polpo/picogus/hw-hand386/PicoGUS Hand386.kicad_pcb

## KiCad design hw-hand386/PicoGUS Hand386.kicad_pcb (2024-06-30)

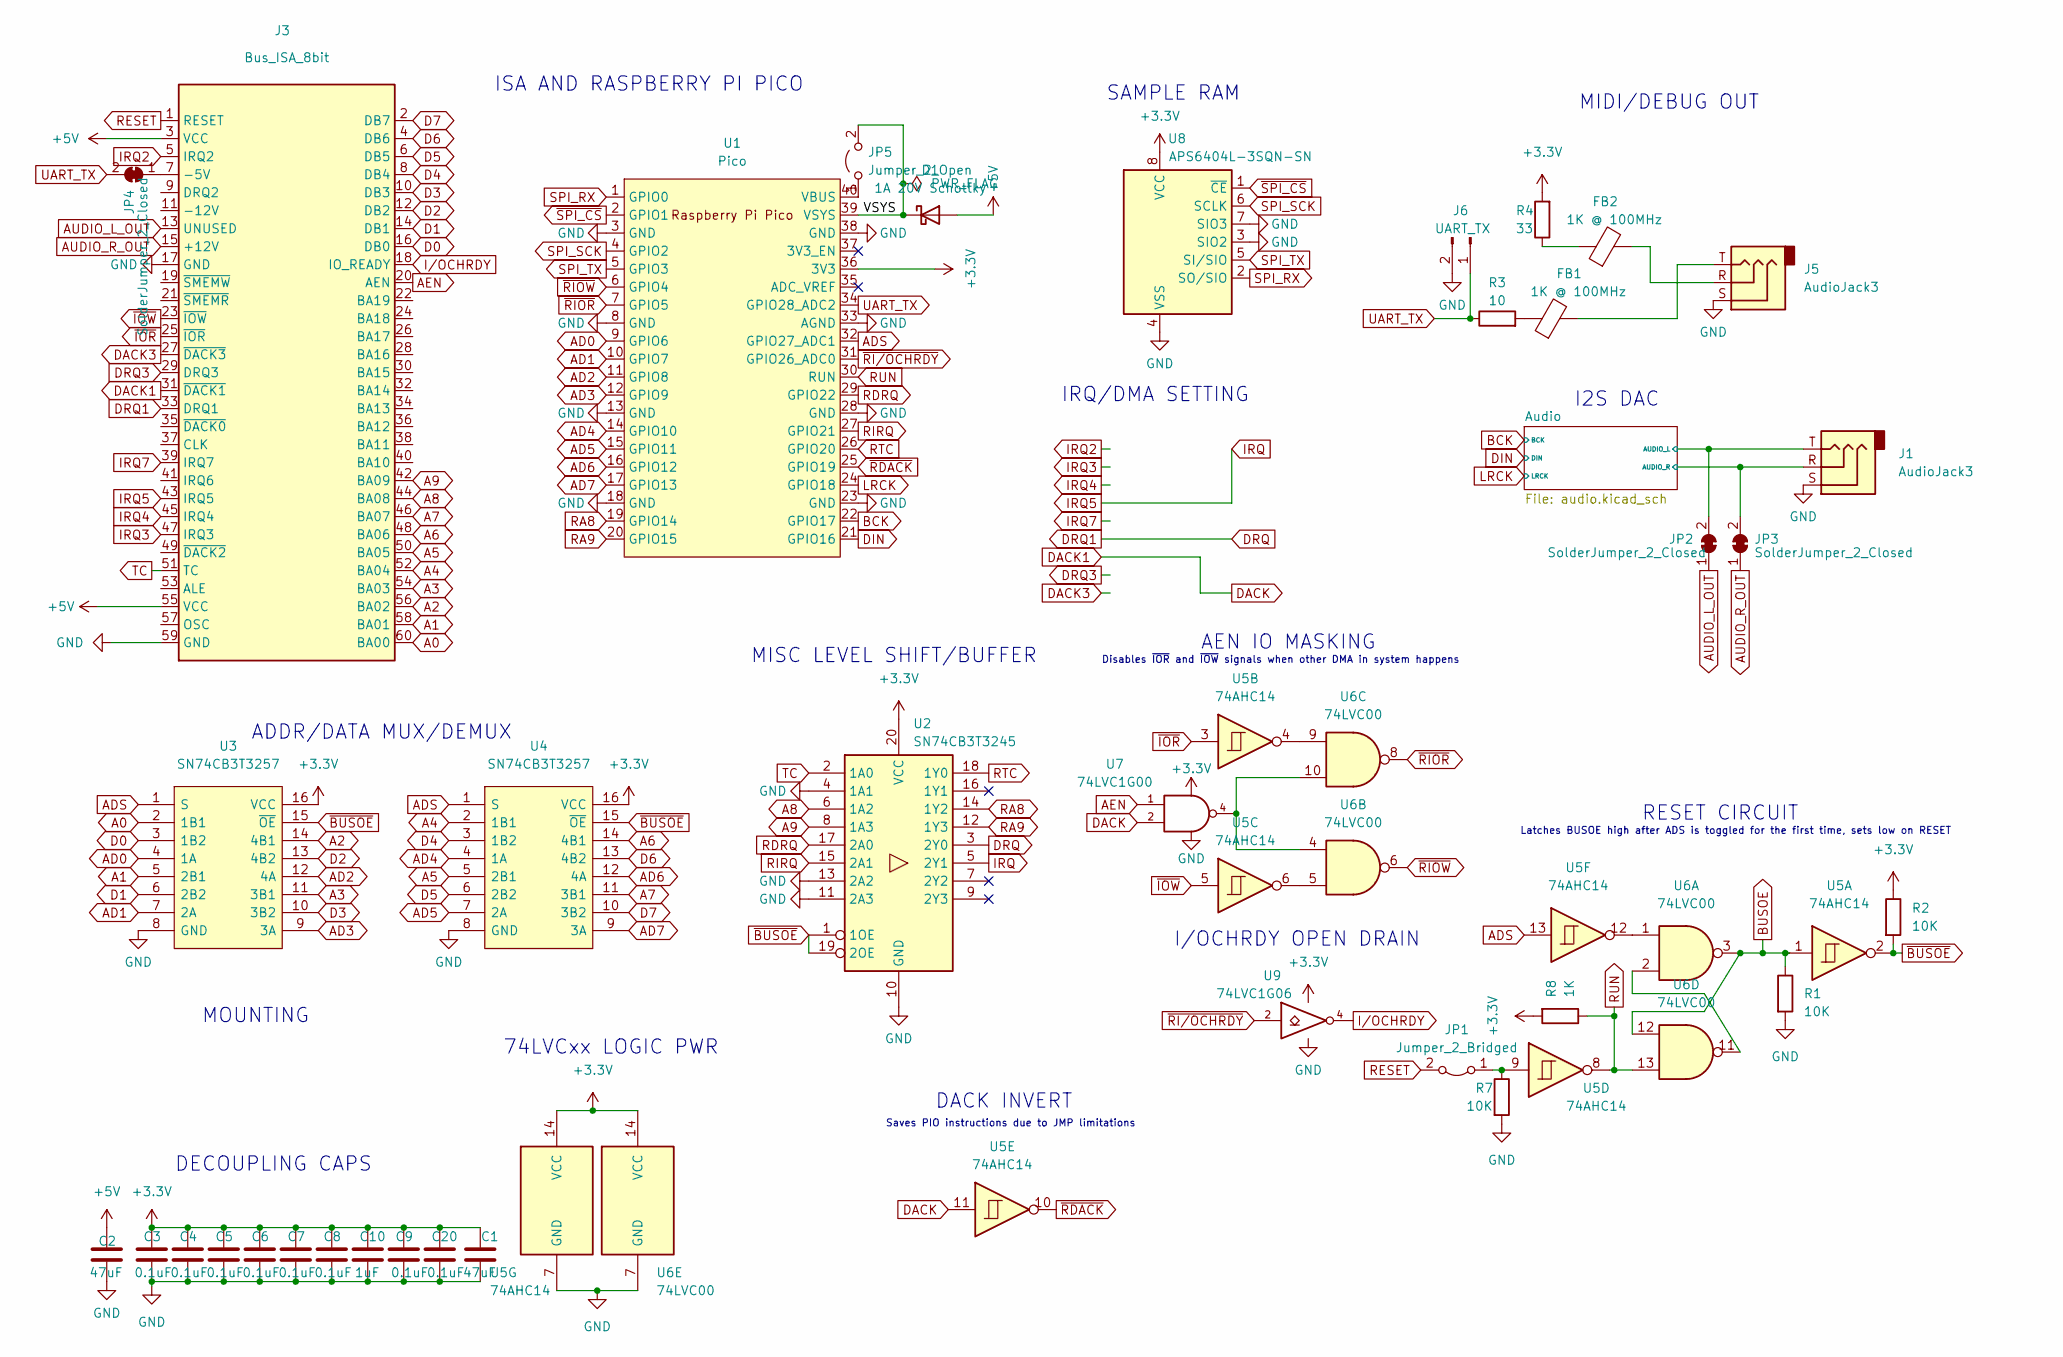
[picture p1: schematic PicoGUS Hand386.kicad_sch, PicoGUS v1.1]

Parts:
C1, C2: 47uF; C_1206_3216Metric
C3, C4, C5, C6, C7, C8, C9, C20: 0.1uF; C_0402_1005Metric
C10: 1uF; C_0402_1005Metric
D1: 1A 20V Schottky; D_SOD-123
FB1, FB2: 1K @ 100MHz; L_0603_1608Metric
J1: AudioJack3; PJ-321A
J3: Bus_ISA_8bit; EDGE-60
J5: AudioJack3; PJ-231F-4A
J6: UART_TX; PinHeader_1x02_P2.54mm_Vertical
JP1: Jumper_2_Bridged; PinHeader_1x02_P2.54mm_Vertical
JP2, JP3, JP4: SolderJumper_2_Closed; SolderJumper-2_P1.3mm_Bridged_RoundedPad1.0x1.5mm-nomask
JP5: Jumper_2_Open; PinHeader_1x02_P2.54mm_Vertical
R1, R2, R7: 10K; R_0402_1005Metric
R3: 10; R_0805_2012Metric
R4: 33; R_0805_2012Metric
R8: 1K; R_0402_1005Metric
U1: Pico; RPi_Pico_SMD_TH
U2: SN74CB3T3245; TSSOP-20_4.4x6.5mm_P0.65mm
U3, U4: SN74CB3T3257; TSSOP-16_4.4x5mm_P0.65mm; Manufacturer_Part_Number 74FST3257DR2G; Mouser Part Number 863-74FST3257DR2G
U5: 74AHC14; TSSOP-14_4.4x5mm_P0.65mm
U6: 74LVC00; TSSOP-14_4.4x5mm_P0.65mm
U7: 74LVC1G00; SOT-23-5
U8: APS6404L-3SQN-SN; SOIC-8_3.9x4.9mm_P1.27mm
U9: 74LVC1G06; SOT-23-5

Connections:
+5V: C2.1, D1.2 (A), J3.3 (VCC), J3.55 (VCC)
/Audio/AUDIO_L: J1.T, JP2.2 (B); also elsewhere on the board
/Audio/AUDIO_R: J1.R, JP3.2 (B); also elsewhere on the board
/VSYS: D1.1 (K), JP5.2 (B), U1.39 (VSYS)
A0: J3.60 (BA00), U3.2 (1B1)
A1: J3.58 (BA01), U3.5 (2B1)
A2: J3.56 (BA02), U3.14 (4B1)
A3: J3.54 (BA03), U3.11 (3B1)
A4: J3.52 (BA04), U4.2 (1B1)
A5: J3.50 (BA05), U4.5 (2B1)
A6: J3.48 (BA06), U4.14 (4B1)
A7: J3.46 (BA07), U4.11 (3B1)
A8: J3.44 (BA08), U2.6 (1A2)
A9: J3.42 (BA09), U2.8 (1A3)
AD0: U1.9 (GPIO6), U3.4 (1A)
AD1: U1.10 (GPIO7), U3.7 (2A)
AD2: U1.11 (GPIO8), U3.12 (4A)
AD3: U1.12 (GPIO9), U3.9 (3A)
AD4: U1.14 (GPIO10), U4.4 (1A)
AD5: U1.15 (GPIO11), U4.7 (2A)
AD6: U1.16 (GPIO12), U4.12 (4A)
AD7: U1.17 (GPIO13), U4.9 (3A)
ADS: U1.32 (GPIO27_ADC1), U3.1 (S), U4.1 (S), U5.13
AEN: J3.20 (AEN), U7.1
AUDIO_L_OUT: J3.13 (UNUSED), JP2.1 (A)
AUDIO_R_OUT: J3.15 (+12V), JP3.1 (A)
BCK: U1.22 (GPIO17); also elsewhere on the board
BUSOE: R1.1, U5.1, U6.3, U6.12
D0: J3.16 (DB0), U3.3 (1B2)
D1: J3.14 (DB1), U3.6 (2B2)
D2: J3.12 (DB2), U3.13 (4B2)
D3: J3.10 (DB3), U3.10 (3B2)
D4: J3.8 (DB4), U4.3 (1B2)
D5: J3.6 (DB5), U4.6 (2B2)
D6: J3.4 (DB6), U4.13 (4B2)
D7: J3.2 (DB7), U4.10 (3B2)
DACK: J3.31 (~DACK1), U5.11, U7.2
DACK3: J3.27 (~DACK3)
DIN: U1.21 (GPIO16); also elsewhere on the board
DRQ: J3.33 (DRQ1), U2.3 (2Y0)
DRQ3: J3.29 (DRQ3)
GND: C1.2, C2.2, C3.2, C4.2, C5.2, C6.2, C7.2, C8.2, C9.2, C10.2, C20.2, J1.S, J3.17 (GND), J3.59 (GND), J5.S, J6.2, R1.2, R7.2, U1.3 (GND), U1.8 (GND), U1.13 (GND), U1.18 (GND), U1.23 (GND), U1.28 (GND), U1.33 (AGND), U1.38 (GND), U2.4 (1A1), U2.10 (GND), U2.11 (2A3), U2.13 (2A2), U3.8 (GND), U4.8 (GND), U5.7 (GND), U6.7 (GND), U7.3 (GND), U8.3 (SIO2), U8.4 (VSS), U8.7 (SIO3), U9.3 (GND); also elsewhere on the board
IRQ: J3.43 (IRQ5), U2.5 (2Y1)
IRQ2: J3.5 (IRQ2)
IRQ3: J3.47 (IRQ3)
IRQ4: J3.45 (IRQ4)
IRQ7: J3.39 (IRQ7)
I/OCHRDY: J3.18 (IO_READY), U9.4
LRCK: U1.24 (GPIO18); also elsewhere on the board
unnamed: FB1.1, R3.2
unnamed: FB1.2, J5.T
unnamed: FB2.1, R4.1
unnamed: FB2.2, J5.R
unnamed: J3.7 (-5V), JP4.1 (A)
unnamed: JP1.1 (A), R7.1, U5.9
unnamed: JP5.1 (A), U1.40 (VBUS)
unnamed: U5.4, U6.9
unnamed: U5.6, U6.5
unnamed: U5.12, U6.1
unnamed: U6.4, U6.10, U7.4
unnamed: U6.2, U6.11
RA8: U1.19 (GPIO14), U2.14 (1Y2)
RA9: U1.20 (GPIO15), U2.12 (1Y3)
RDRQ: U1.29 (GPIO22), U2.17 (2A0)
RESET: J3.1 (RESET), JP1.2 (B)
RIRQ: U1.27 (GPIO21), U2.15 (2A1)
RTC: U1.26 (GPIO20), U2.18 (1Y0)
RUN: R8.1, U1.30 (RUN), U5.8, U6.13
SPI_RX: U1.1 (GPIO0), U8.2 (SO/SIO)
SPI_SCK: U1.4 (GPIO2), U8.6 (SCLK)
SPI_TX: U1.5 (GPIO3), U8.5 (SI/SIO)
TC: J3.51 (TC), U2.2 (1A0)
UART_TX: J6.1, JP4.2 (B), R3.1, U1.34 (GPIO28_ADC2)
~BUSOE: R2.2, U2.1 (1OE), U2.19 (2OE), U3.15 (~OE), U4.15 (~OE), U5.2
~IOR: J3.25 (~IOR), U5.3
~IOW: J3.23 (~IOW), U5.5
~RDACK: U1.25 (GPIO19), U5.10
~RIOR: U1.7 (GPIO5), U6.8
~RIOW: U1.6 (GPIO4), U6.6
~RI/OCHRDY: U1.31 (GPIO26_ADC0), U9.2
~SPI_CS: U1.2 (GPIO1), U8.1 (~CE)

Notes on the sheet:
Saves PIO instructions due to JMP limitations
DECOUPLING CAPS
I2S DAC
Disables ~{IOR} and ~{IOW} signals when other DMA in system happens
Latches BUSOE high after ADS is toggled for the first time, sets low on RESET
MIDI/DEBUG OUT
MOUNTING
MISC LEVEL SHIFT/BUFFER
IRQ/DMA SETTING
DACK INVERT
ADDR/DATA MUX/DEMUX
SAMPLE RAM
AEN IO MASKING
ISA AND RASPBERRY PI PICO
RESET CIRCUIT
I/OCHRDY OPEN DRAIN
74LVCxx LOGIC PWR

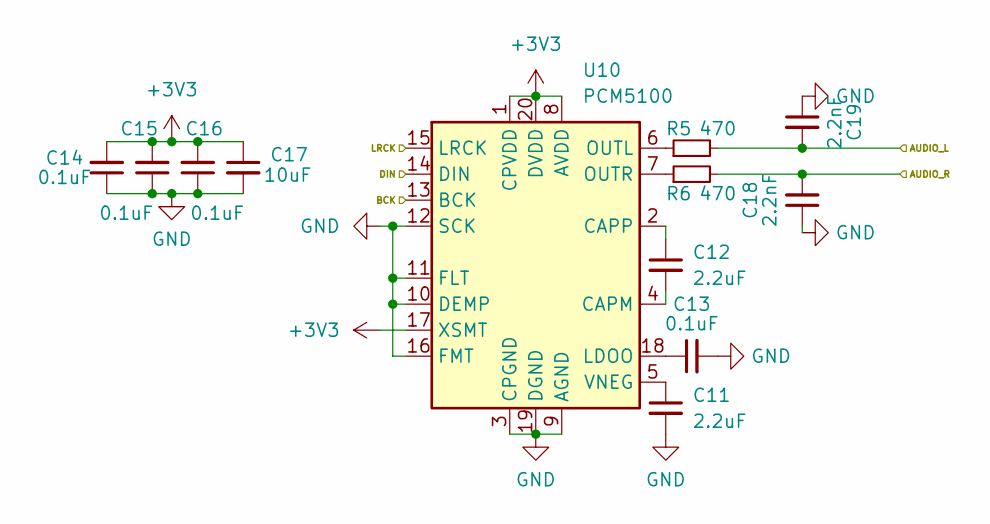
[picture p2: schematic audio.kicad_sch]

Parts:
C11, C12: 2.2uF; C_0402_1005Metric
C13, C14, C15, C16: 0.1uF; C_0402_1005Metric
C17: 10uF; C_0603_1608Metric
C18, C19: 2.2nF; C_0402_1005Metric
R5, R6: 470; R_0402_1005Metric
U10: PCM5100; TSSOP-20_4.4x6.5mm_P0.65mm

Connections:
/Audio/AUDIO_L: C19.2, R5.2; also elsewhere on the board
/Audio/AUDIO_R: C18.2, R6.2; also elsewhere on the board
BCK: U10.13 (BCK); also elsewhere on the board
DIN: U10.14 (DIN); also elsewhere on the board
GND: C11.2, C13.2, C14.1, C15.1, C16.1, C17.2, C18.1, C19.1, U10.3 (CPGND), U10.9 (AGND), U10.10 (DEMP), U10.11 (FLT), U10.12 (SCK), U10.16 (FMT), U10.19 (DGND); also elsewhere on the board
LRCK: U10.15 (LRCK); also elsewhere on the board
unnamed: C12.2, U10.4 (CAPM)
unnamed: C12.1, U10.2 (CAPP)
unnamed: C13.1, U10.18 (LDOO)
unnamed: R5.1, U10.6 (OUTL)
unnamed: R6.1, U10.7 (OUTR)
unnamed: C11.1, U10.5 (VNEG)

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
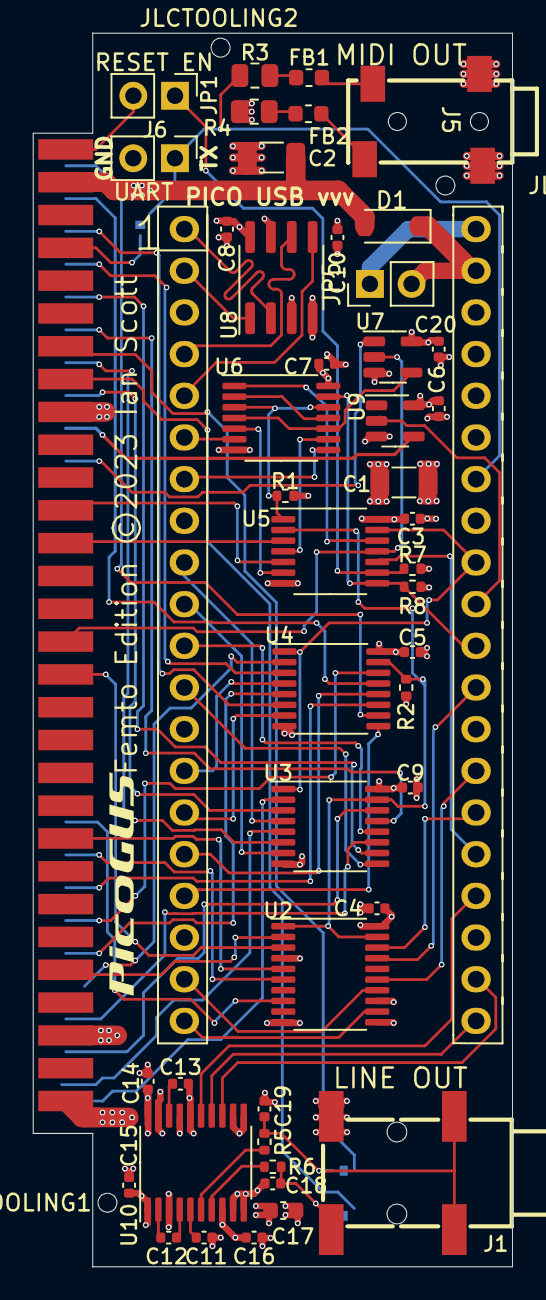
[picture p3: board PicoGUS Hand386.kicad_pcb from above]

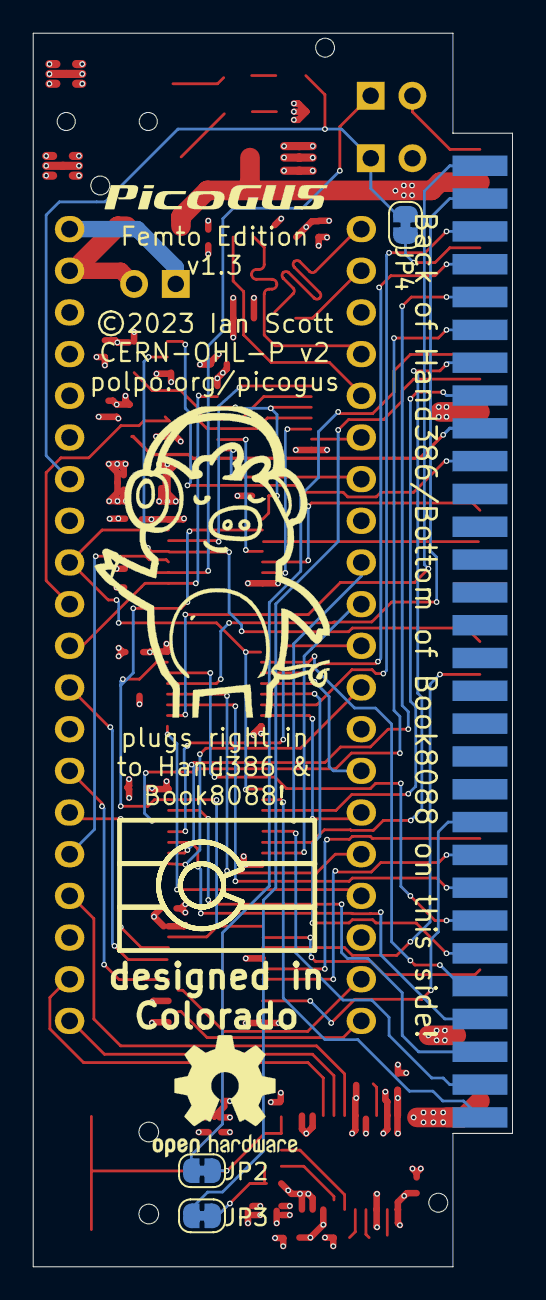
[picture p4: board PicoGUS Hand386.kicad_pcb from below]

Board: 4 copper layers, 29.2 x 75.2 mm, 53 parts (3 on the bottom side), 82 nets.

Other parts of the board:
JLCTOOLING1, JLCTOOLING2, JLCTOOLING3: JLCPCB-tooling
