polpo/picogus/(notices)

Notices in the files:
hw-hand386/PicoGUS Hand386.kicad_pcb:
©2023 Ian Scott
CERN-OHL-P v2
Femto Edition ©2023 Ian Scott
hw/PicoGUS.kicad_pcb:
© 2023 Ian Scott aka polpo
licensed under CERN-OHL-P v2
